luckymuniza/spinkovacka/hw_v2.0/control_board/control_board_schematic_v2.pdf

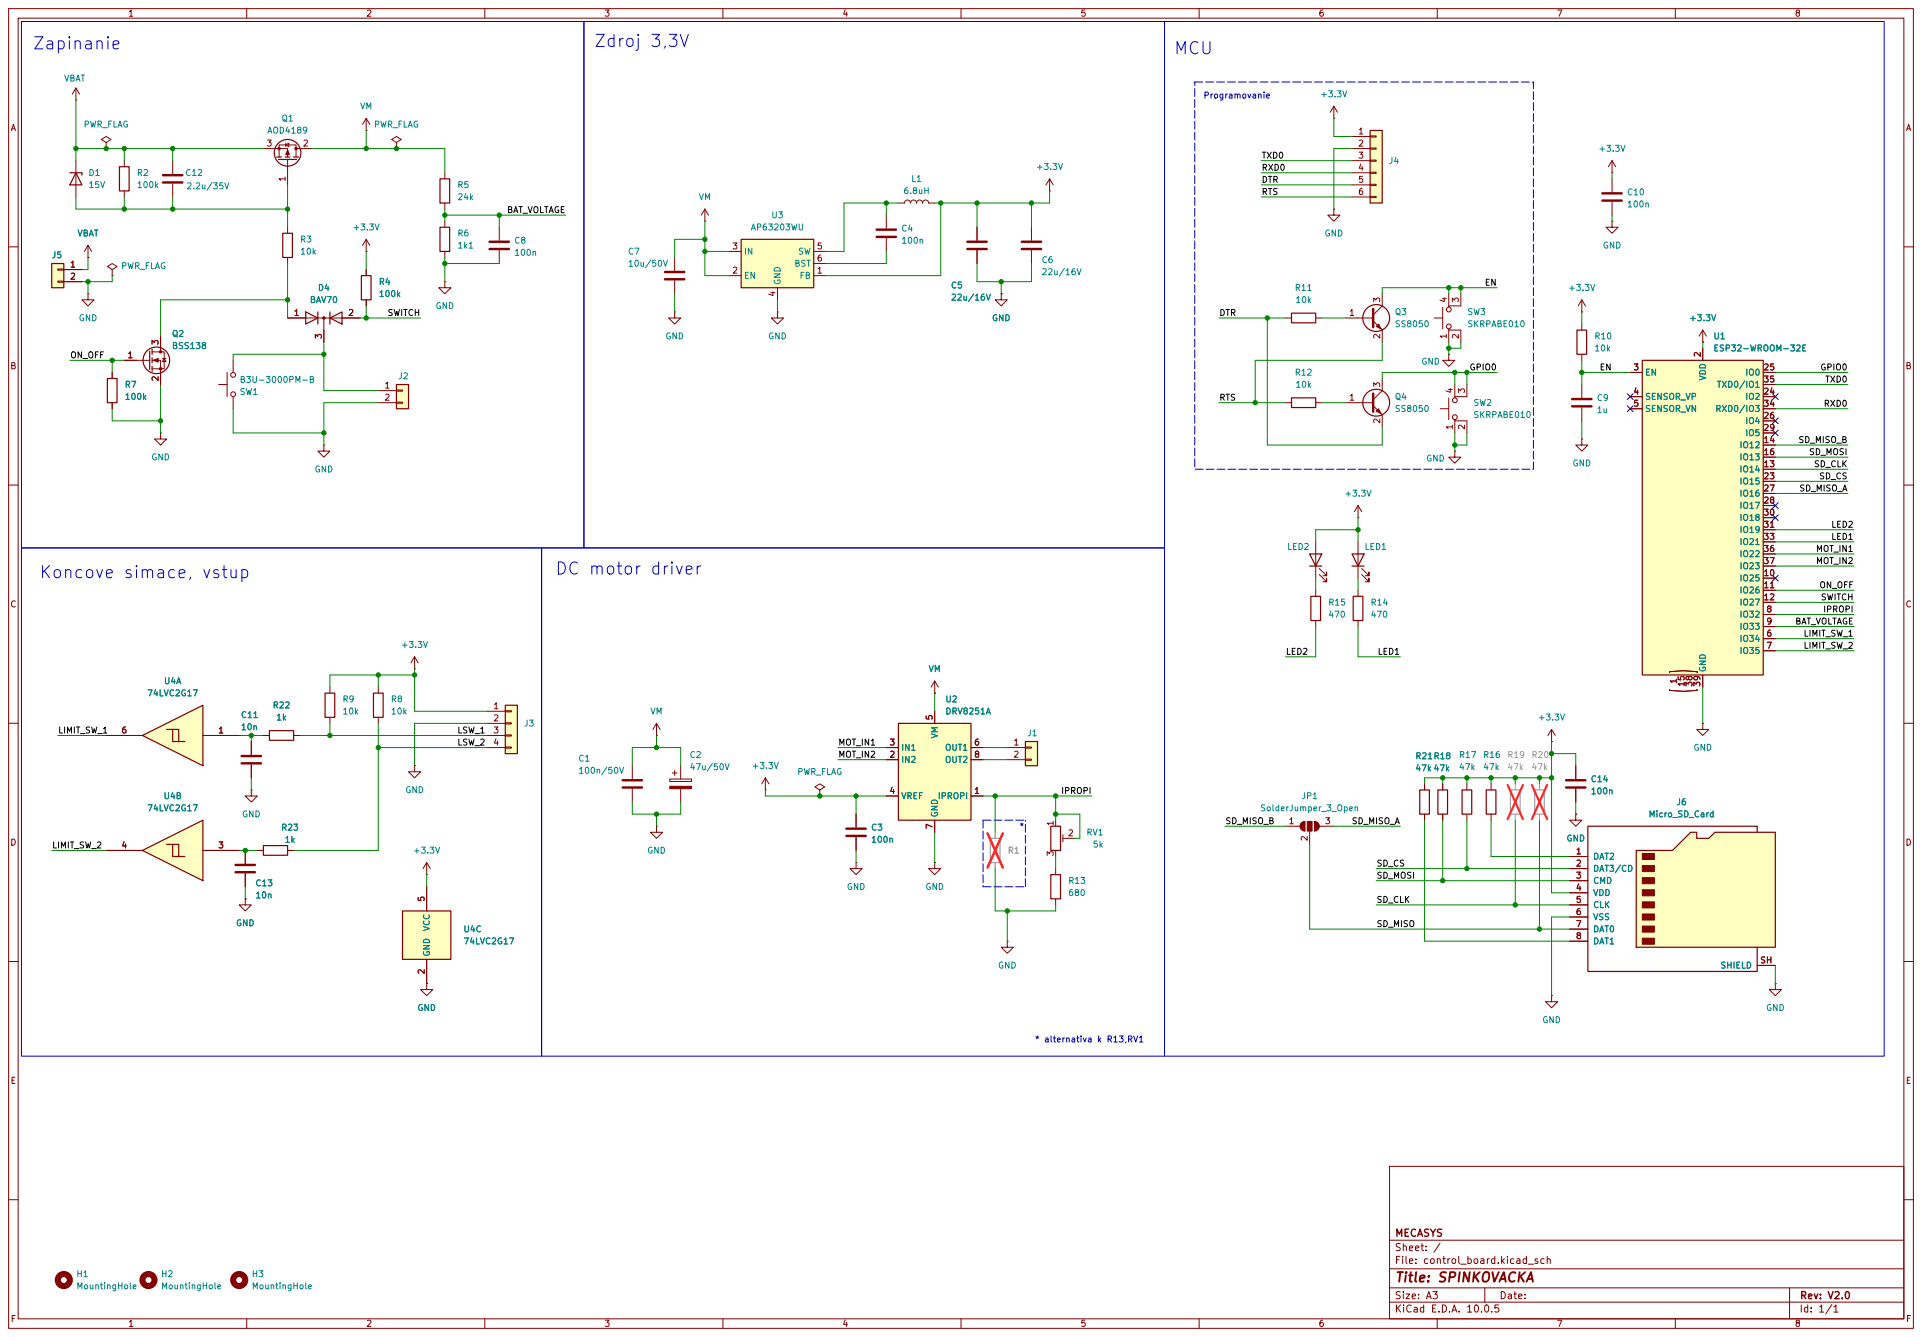
[picture p1: page 1]

Size: A3 | Rev: V2.0 | F Date:
KiCad E.D.A. 10.0.5 | Id: 1/1
