luckymuniza/spinkovacka/hw/snimac/snimac_schematic.pdf

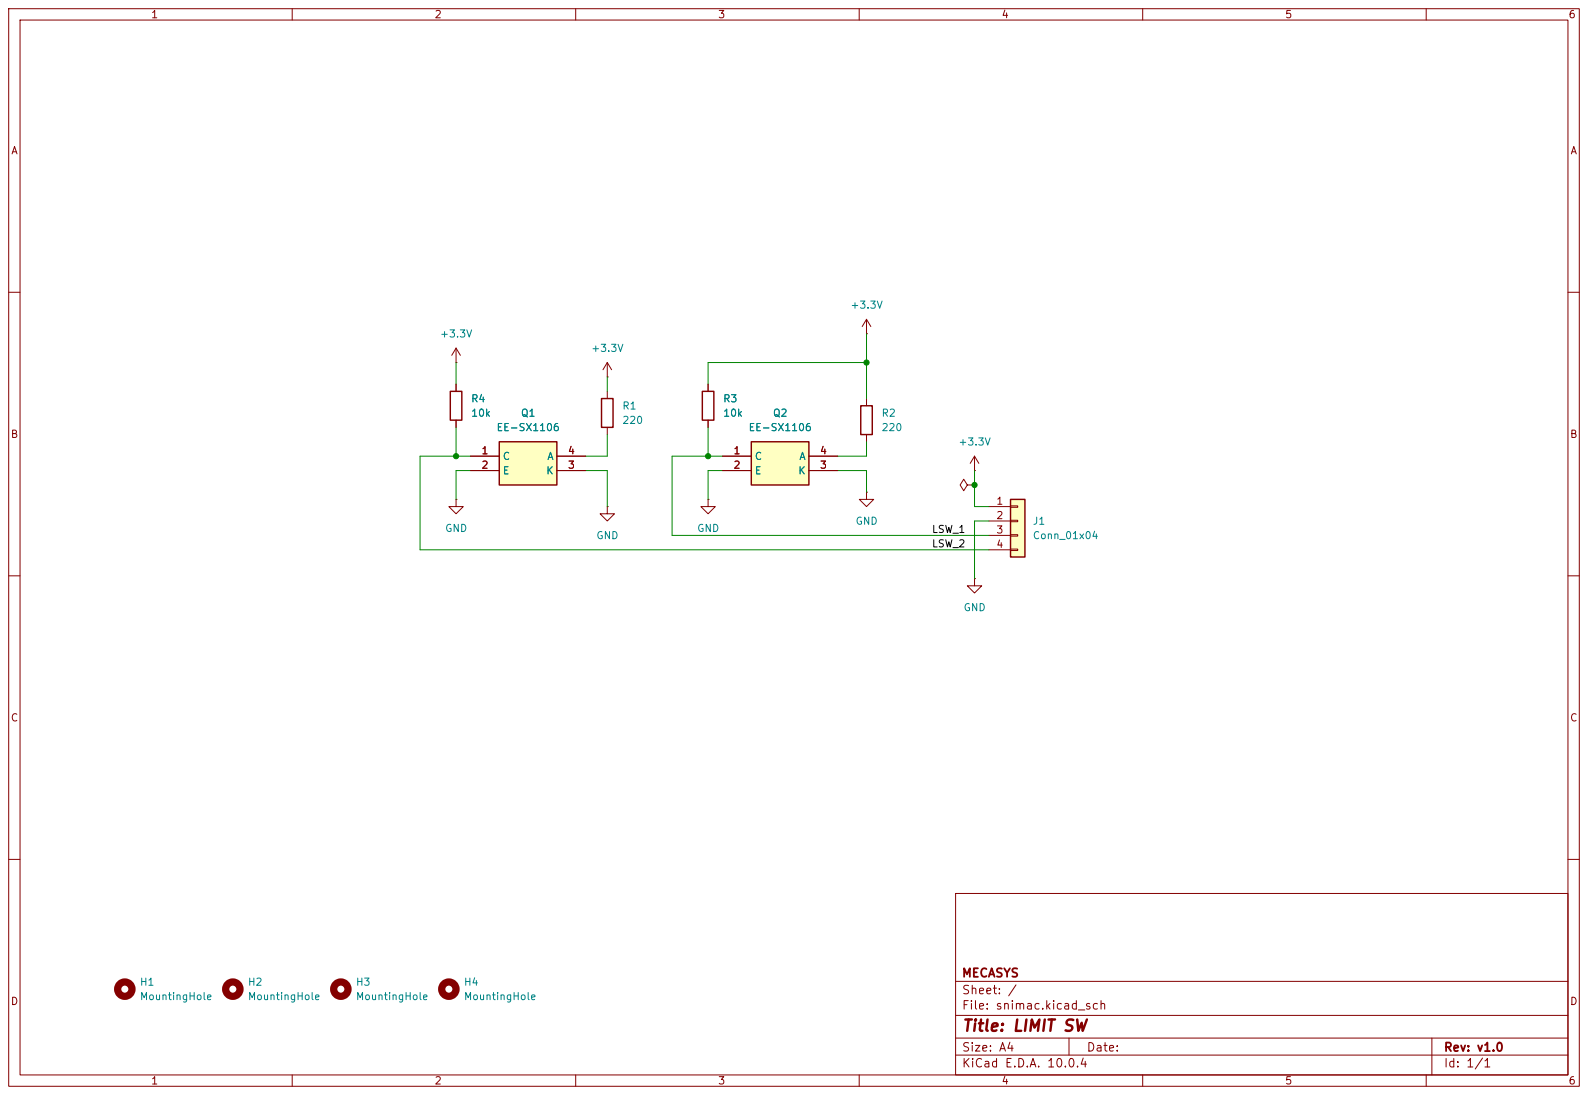
[picture p2: page 1]

Size: A4 | Rev: v1.0
KiCad E.D.A. 10.0.4 | Id: 1/1
