luckymuniza/spinkovacka/hw/control_board/control_board_schematic.pdf

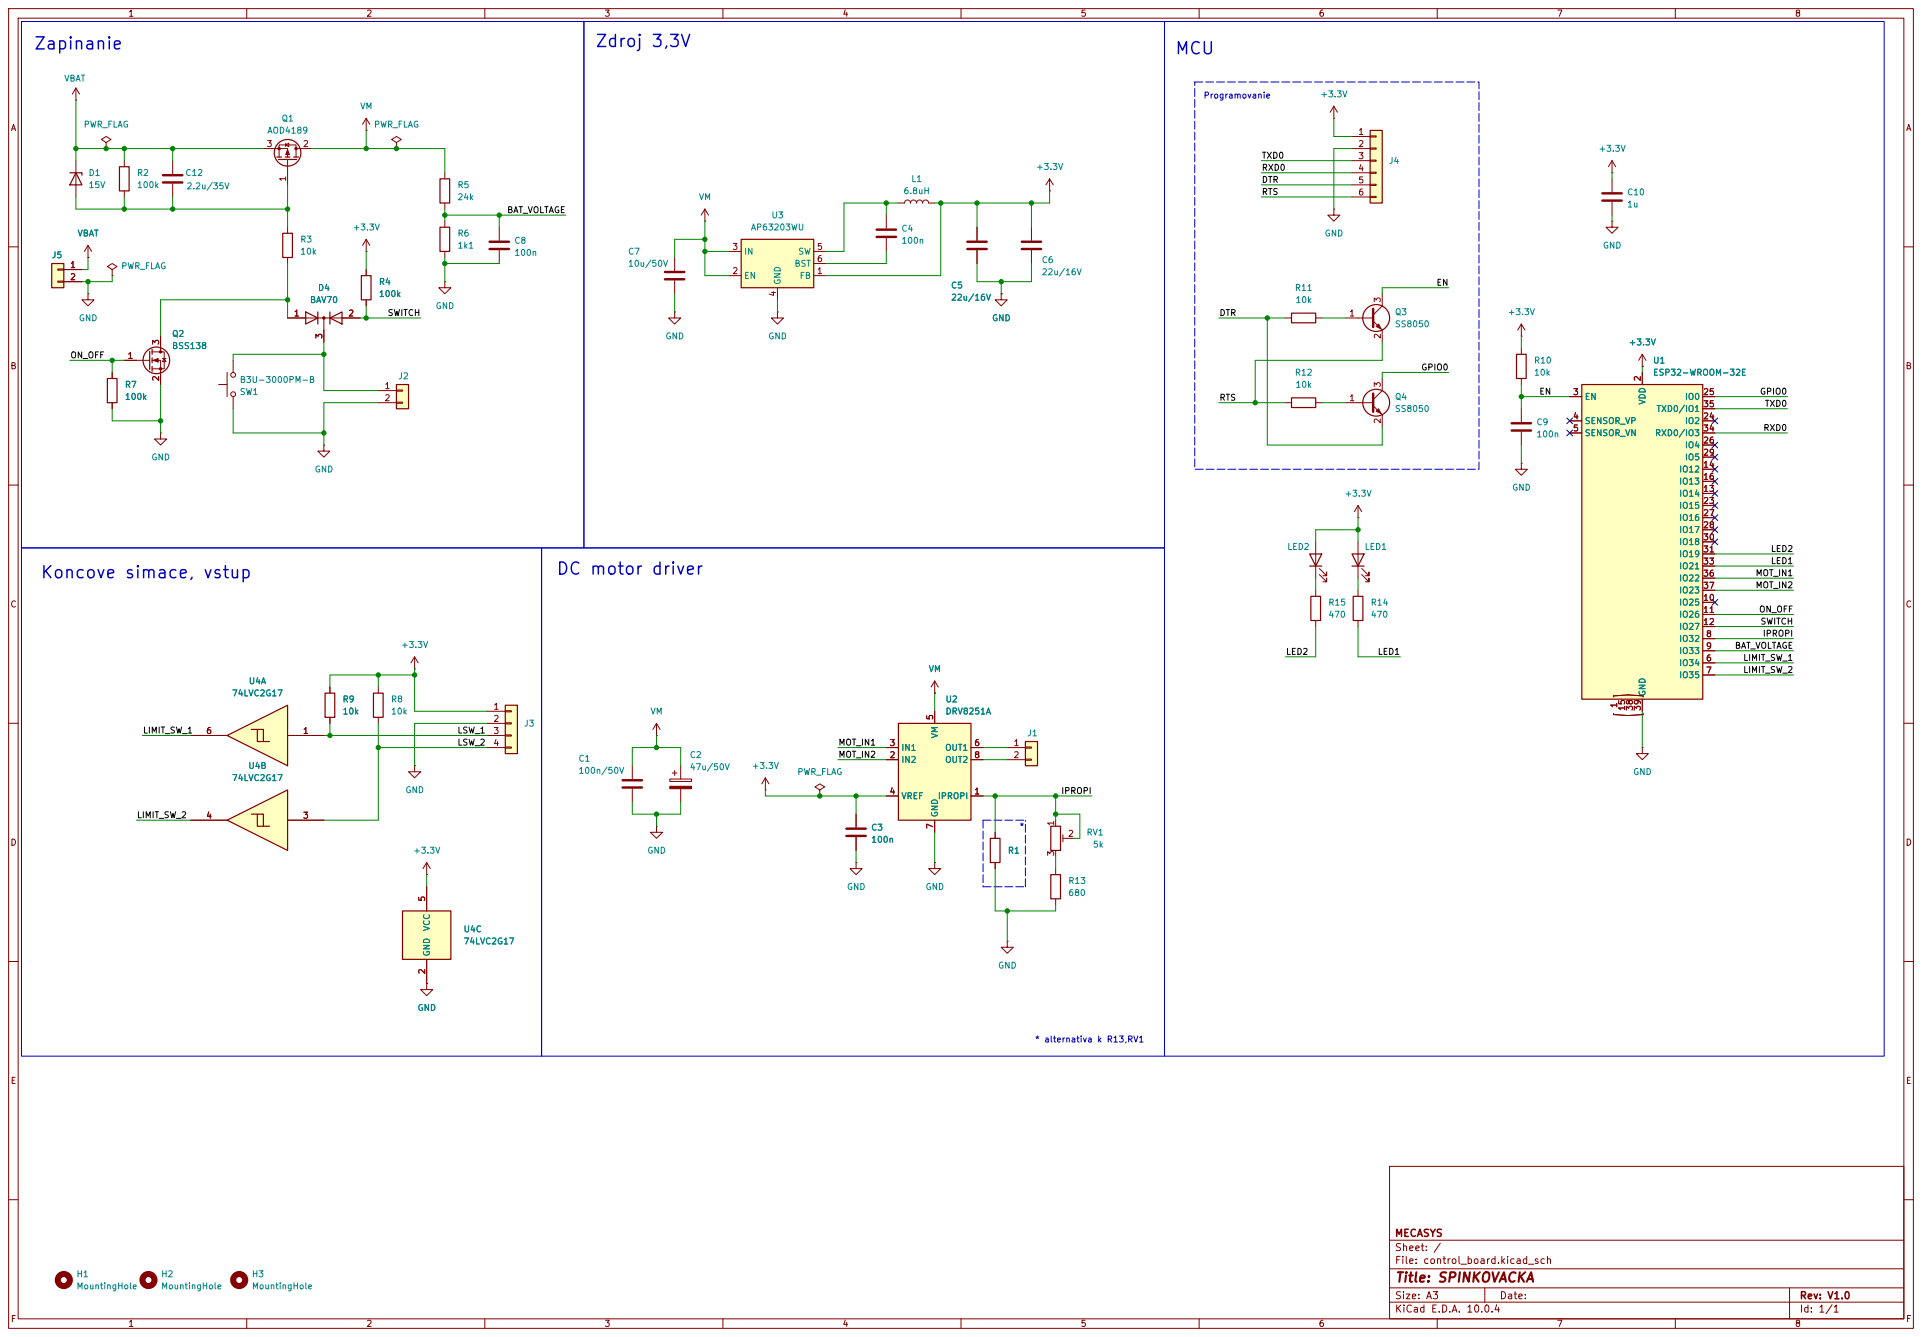
[picture p3: page 1]

RTS Koncove simace, vstup

Size: A3 | Rev: V1.0 | F Date:
KiCad E.D.A. 10.0.4 | Id: 1/1
