luckymuniza/spinkovacka/hw_v2.0/control_board/control_board.kicad_pcb

## KiCad design hw_v2.0/control_board/control_board.kicad_pcb (2026-10-12)

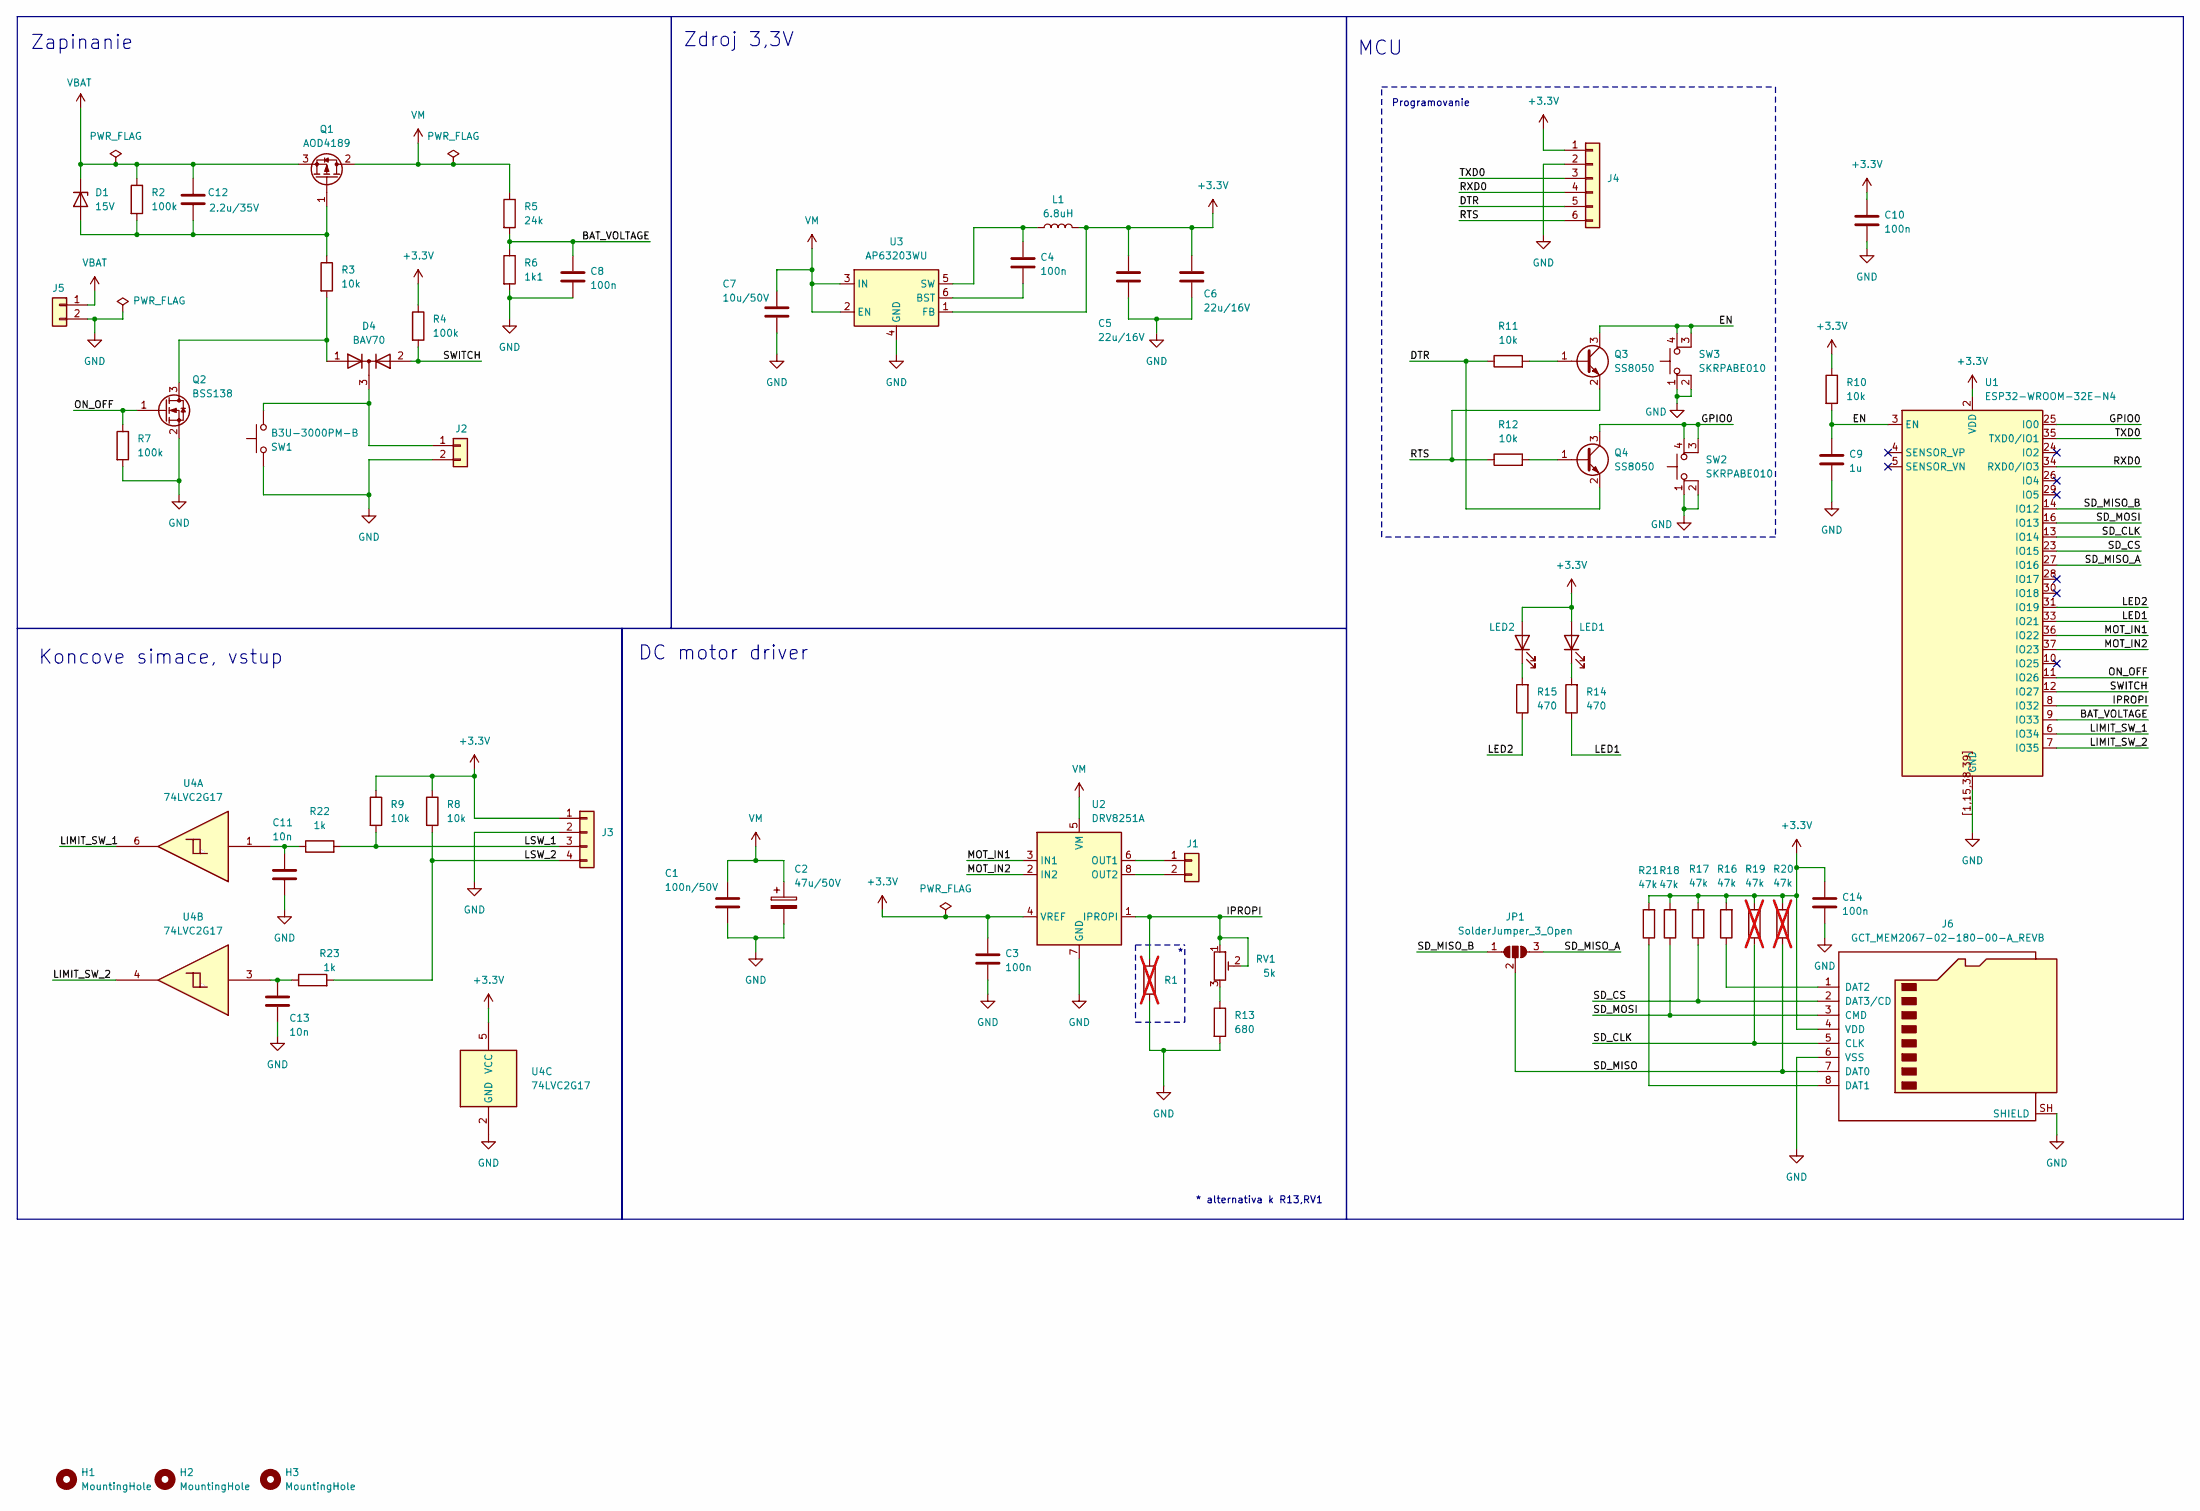
[picture p4: schematic control_board.kicad_sch, SPINKOVACKA]

Parts:
C1: 100n/50V; C_1206_3216Metric
C2: 47u/50V; CP_Elec_6.3x5.8
C3, C4, C8, C10: 100n; C_1206_3216Metric
C5, C6: 22u/16V; C_1206_3216Metric
C7: 10u/50V; C_1210_3225Metric
C9: 1u; C_1206_3216Metric
C11, C13: 10n; C_0805_2012Metric
C12: 2.2u/35V; C_1206_3216Metric
C14: 100n; C_0805_2012Metric_Pad1.18x1.45mm_HandSolder
D1: 15V; Nexperia_CFP3_SOD-123W
D4: BAV70; SOT-23
H1, H2, H3: MountingHole; MountingHole_3.2mm_M3
J1: JST_XH_B2B-XH-A_1x02_P2.50mm_Vertical
J2: JST_PH_B2B-PH-K_1x02_P2.00mm_Vertical
J3: JST_PH_B4B-PH-K_1x04_P2.00mm_Vertical
J4: JST_PH_B6B-PH-K_1x06_P2.00mm_Vertical
J5: JST_VH_B2PS-VH_1x02_P3.96mm_Horizontal
J6: GCT_MEM2067-02-180-00-A_REVB
JP1: SolderJumper_3_Open; SolderJumper-3_P1.3mm_Open_RoundedPad1.0x1.5mm_NumberLabels
L1: 6.8uH; L_Panasonic_PCC-M0530M
LED1, LED2: LED_1206_3216Metric
Q1: AOD4189; TO-252-2
Q2: BSS138; SOT-23
Q3, Q4: SS8050; SOT-23
R1: 1k5; R_0805_2012Metric; not fitted
R2, R4, R7: 100k; R_0805_2012Metric
R3, R8, R9, R10, R11, R12: 10k; R_0805_2012Metric
R5: 24k; R_0805_2012Metric
R6: 1k1; R_0805_2012Metric
R13: 680; R_0805_2012Metric
R14, R15: 470; R_0805_2012Metric
R16, R17, R18, R21: 47k; R_0805_2012Metric
R19, R20: 47k; R_0805_2012Metric; not fitted
R22, R23: 1k; R_0805_2012Metric
RV1: 5k; Potentiometer_Bourns_3314J_Vertical
SW1: B3U-3000PM-B; SW_SPST_B3U-3000P-B
SW2, SW3: SKRPABE010; SW_TACT_ALPS_SKRPABE010
U1: ESP32-WROOM-32E-N4; ESP32-WROOM-32E
U2: DRV8251A; SOIC-8-1EP_3.9x4.9mm_P1.27mm_EP2.95x4.9mm_Mask2.71x3.4mm_Th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
U3: AP63203WU; TSOT-23-6
U4: 74LVC2G17; SOT-23-6

Connections:
+3.3V: C3.1, C5.1, C6.1, C10.1, C14.1, J3.1, J4.1, J6.4 (VDD), L1.2, LED1.2 (A), LED2.2 (A), R4.1, R8.1, R9.1, R10.1, R16.2, R17.2, R18.2, R19.2, R20.2, R21.2, U1.2 (VDD), U2.4 (VREF), U3.1 (FB), U4.5 (VCC)
/BAT_VOLTAGE: C8.1, R5.2, R6.1, U1.9 (IO33)
/DTR: J4.5, Q4.2 (E), R11.1
/EN: C9.1, Q3.3 (C), R10.2, SW3.3 (K), SW3.4 (A), U1.3 (EN)
/GPIO0: Q4.3 (C), SW2.3 (K), SW2.4 (A), U1.25 (IO0)
/IPROPI: R1.1, RV1.1, RV1.2, U1.8 (IO32), U2.1 (IPROPI)
/LED1: R14.1, U1.33 (IO21)
/LED2: R15.1, U1.31 (IO19)
/LIMIT_SW_1: U1.6 (IO34), U4.6
/LIMIT_SW_2: U1.7 (IO35), U4.4
/LSW_1: J3.3, R9.2, R22.2
/LSW_2: J3.4, R8.2, R23.2
/MOT_IN1: U1.36 (IO22), U2.3 (IN1)
/MOT_IN2: U1.37 (IO23), U2.2 (IN2)
/ON_OFF: Q2.1 (G), R7.1, U1.11 (IO26)
/RTS: J4.6, Q3.2 (E), R12.1
/RXD0: J4.4, U1.34 (RXD0/IO3)
/SD_CLK: J6.5 (CLK), R19.1, U1.13 (IO14)
/SD_CS: J6.2 (DAT3/CD), R17.1, U1.23 (IO15)
/SD_MISO: J6.7 (DAT0), JP1.2 (C), R20.1
/SD_MISO_A: JP1.3 (B), U1.27 (IO16)
/SD_MISO_B: JP1.1 (A), U1.14 (IO12)
/SD_MOSI: J6.3 (CMD), R18.1, U1.16 (IO13)
/SWITCH: D4.2 (A), R4.2, U1.12 (IO27)
/TXD0: J4.3, U1.35 (TXD0/IO1)
GND: C1.2, C2.2, C3.2, C5.2, C6.2, C7.2, C8.2, C9.2, C10.2, C11.2, C13.2, C14.2, J2.2, J3.2, J4.2, J5.2, J6.6 (VSS), J6.SH (SHIELD), Q2.2 (S), R1.2, R6.2, R7.2, R13.2, SW1.2, SW2.1, SW2.2, SW3.1, SW3.2, U1.1 (GND), U1.15 (GND), U1.38 (GND), U1.39 (GND), U1.[1,15,38,39] (GND), U2.7 (GND), U2.9 (GND), U3.4 (GND), U4.2 (GND)
unnamed: C11.1, R22.1, U4.1
unnamed: C13.1, R23.1, U4.3
unnamed: C12.2, D1.2 (A), Q1.1 (G), R2.2, R3.1
unnamed: D4.3 (K), J2.1, SW1.1
unnamed: J1.1, U2.6 (OUT1)
unnamed: J1.2, U2.8 (OUT2)
unnamed: J6.8 (DAT1), R21.1
unnamed: J6.1 (DAT2), R16.1
unnamed: LED1.1 (K), R14.2
unnamed: LED2.1 (K), R15.2
unnamed: D4.1 (A), Q2.3 (D), R3.2
unnamed: Q3.1 (B), R11.2
unnamed: Q4.1 (B), R12.2
unnamed: R13.1, RV1.3
unnamed: C4.2, U3.6 (BST)
unnamed: C4.1, L1.1, U3.5 (SW)
VBAT: C12.1, D1.1 (K), J5.1, Q1.3 (S), R2.1
VM: C1.1, C2.1, C7.1, Q1.2 (D), R5.1, U2.5 (VM), U3.2 (EN), U3.3 (IN)

Notes on the sheet:
MCU
Zapinanie
Zdroj 3,3V
Koncove simace, vstup
Programovanie
DC motor driver
* alternativa k R13,RV1

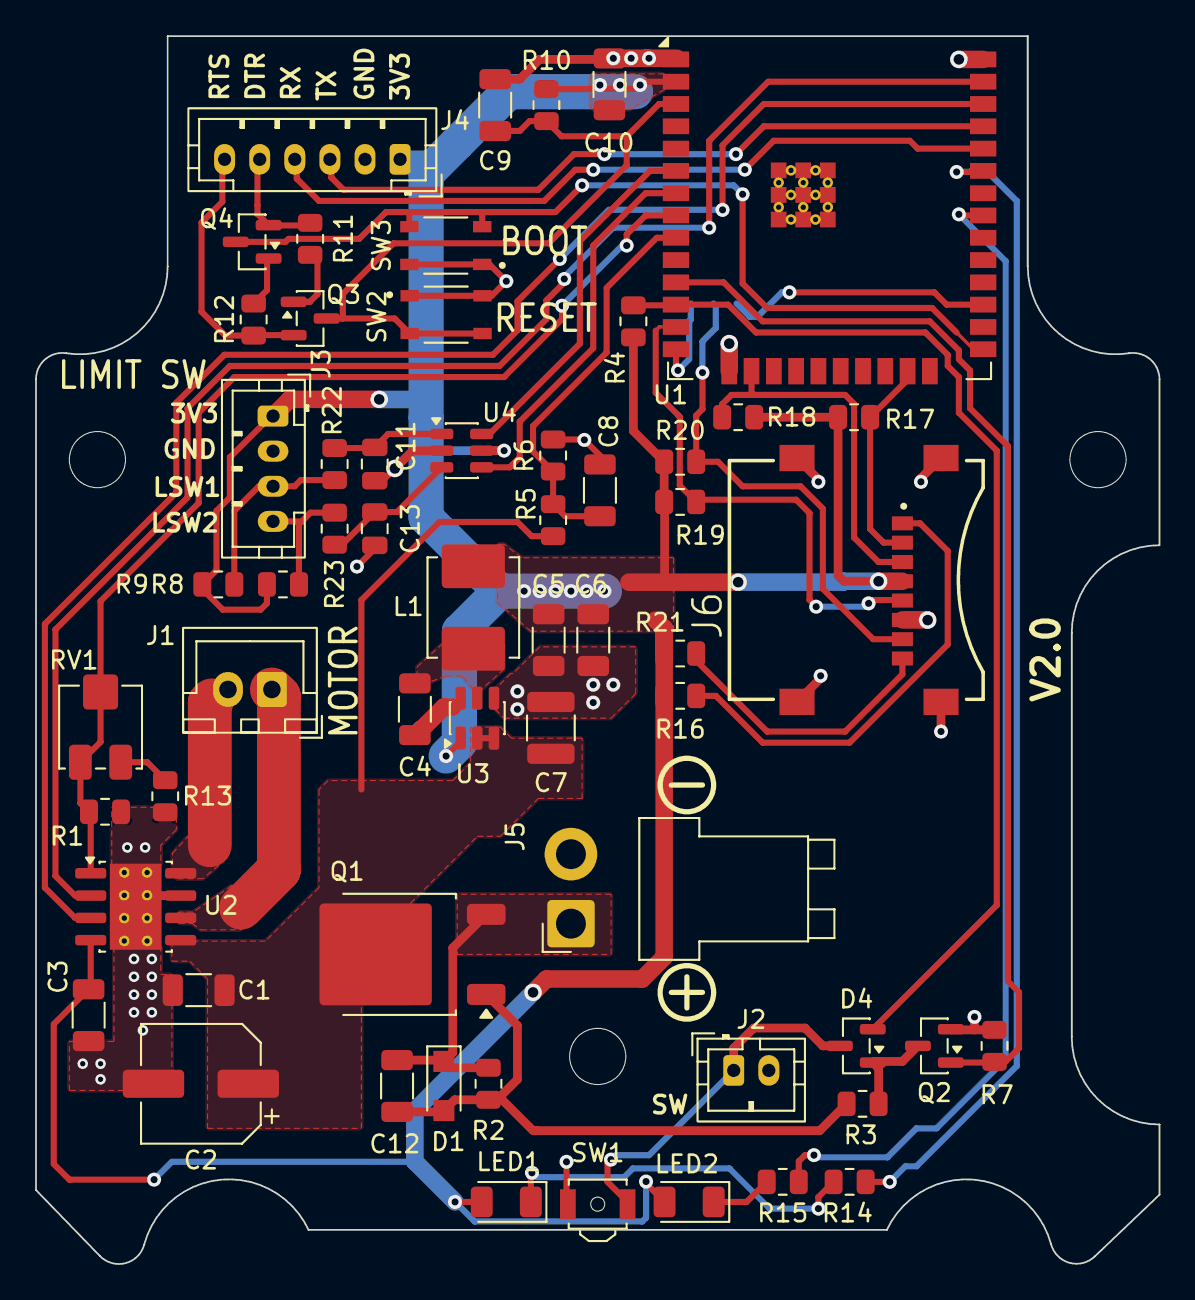
[picture p5: board control_board.kicad_pcb from above]

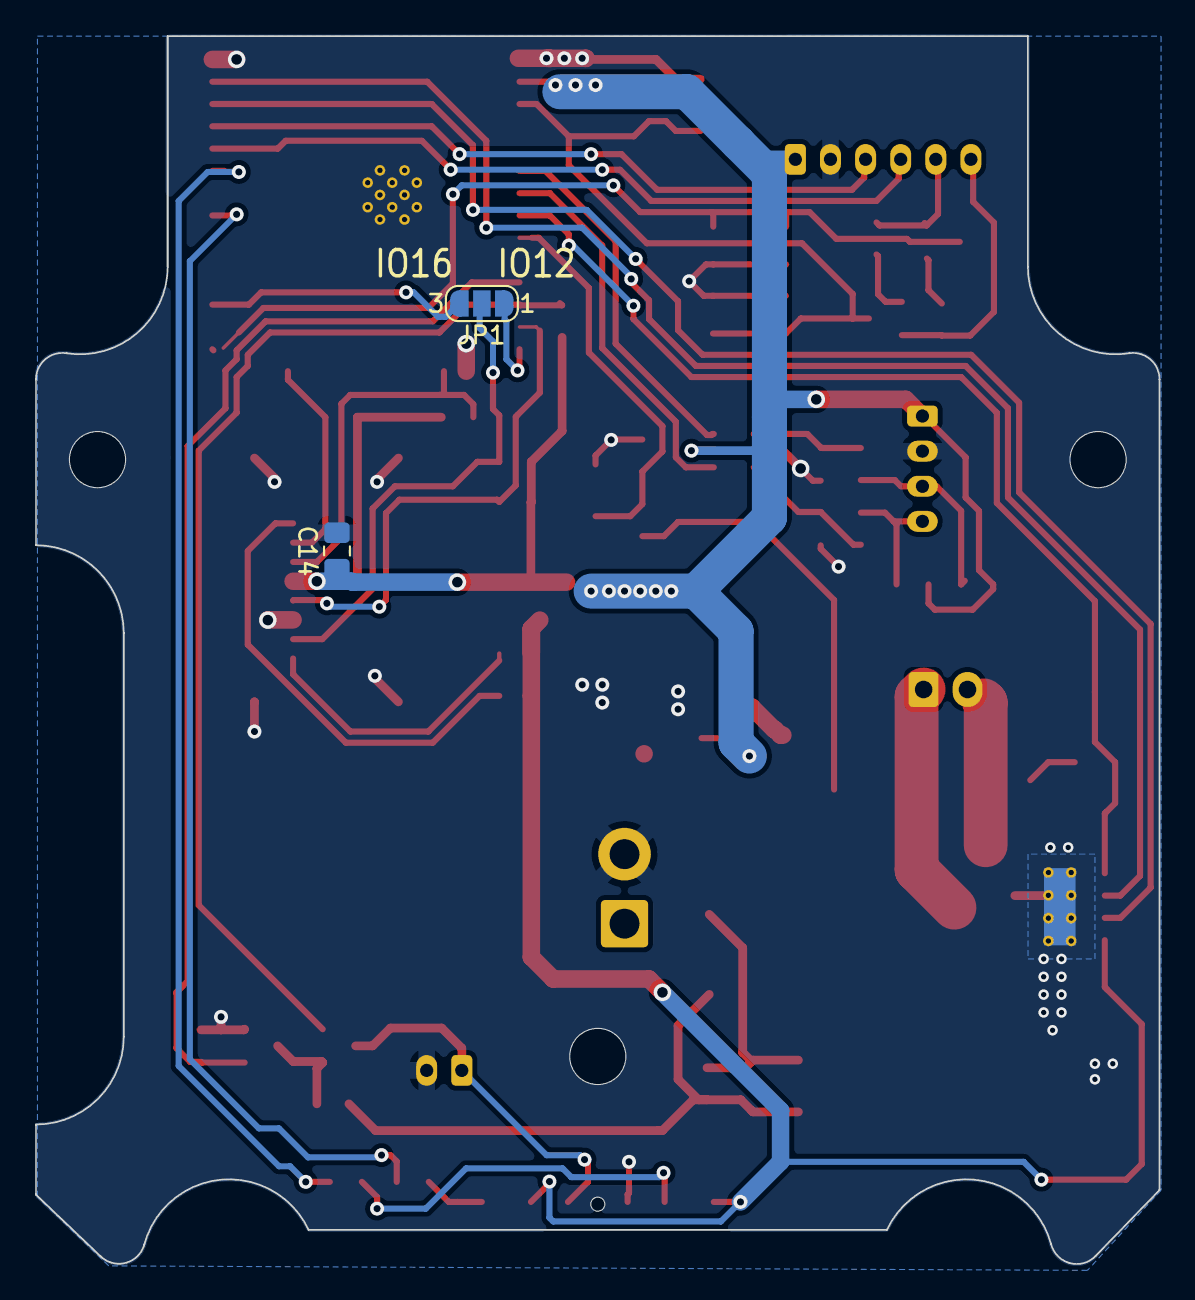
[picture p6: board control_board.kicad_pcb from below]

Board: 2 copper layers, 64.0 x 69.9 mm, 64 parts (2 on the bottom side), 44 nets.
