luckymuniza/spinkovacka/hw_v1.0/snimac/snimac.kicad_pcb

## KiCad design hw_v1.0/snimac/snimac.kicad_pcb (2026-10-11, an earlier design)

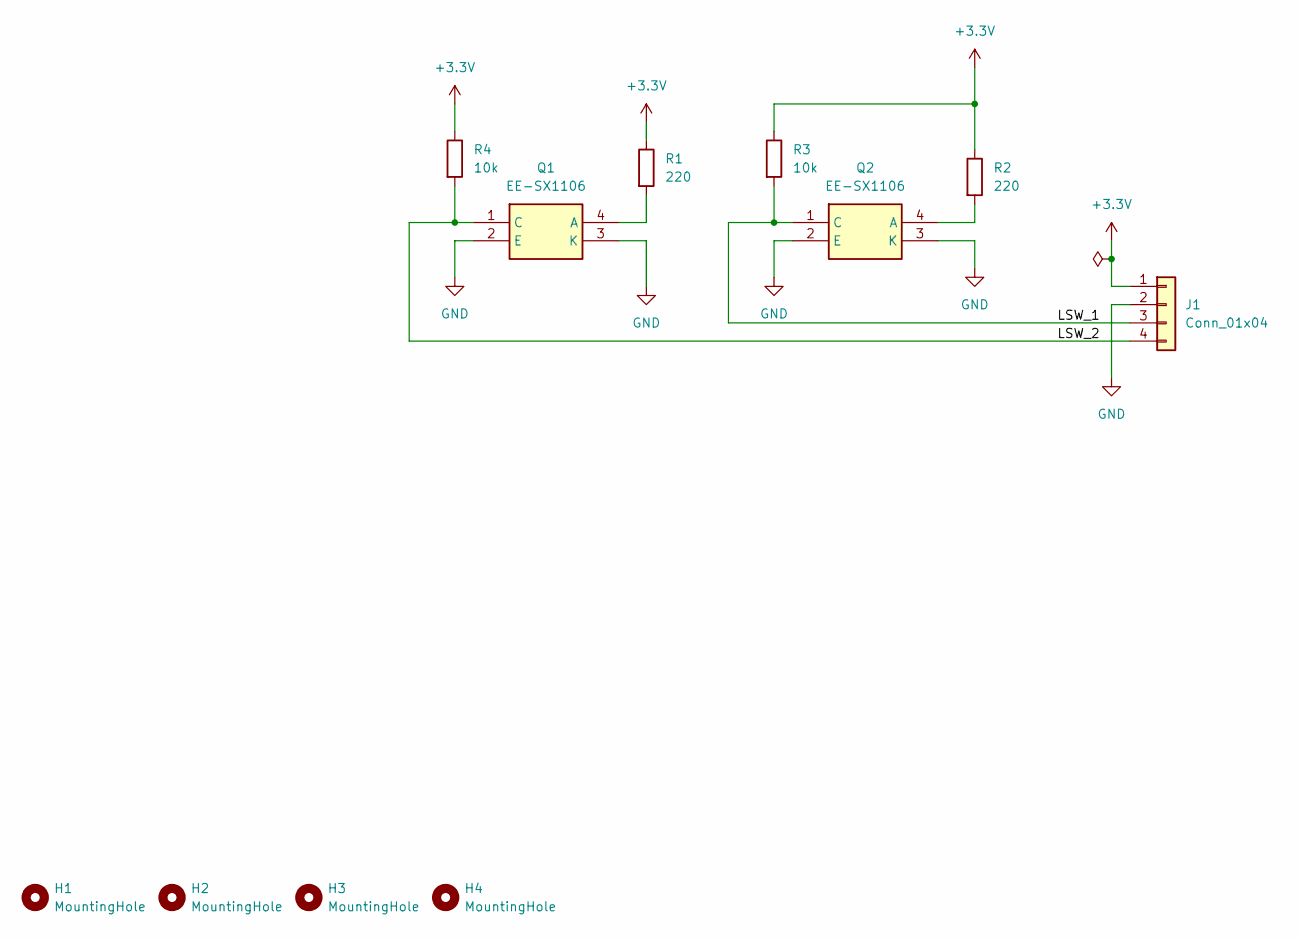
[picture p7: schematic snimac.kicad_sch, LIMIT SW]

Parts:
H1, H2, H3, H4: MountingHole; MountingHole_2.5mm
J1: Conn_01x04; JST_PH_B4B-PH-K_1x04_P2.00mm_Vertical
Q1, Q2: EE-SX1106; EESX1106; Manufacturer_Part_Number EE-SX1106; Mouser Part Number 653-EE-SX1106
R1, R2: 220; R_0805_2012Metric_Pad1.20x1.40mm_HandSolder
R3, R4: 10k; R_0805_2012Metric_Pad1.20x1.40mm_HandSolder

Connections:
+3.3V: J1.1, R1.1, R2.1, R3.1, R4.1
/LSW_1: J1.3, Q2.1 (C), R3.2
/LSW_2: J1.4, Q1.1 (C), R4.2
GND: J1.2, Q1.2 (E), Q1.3 (K), Q2.2 (E), Q2.3 (K)
unnamed: Q1.4 (A), R1.2
unnamed: Q2.4 (A), R2.2

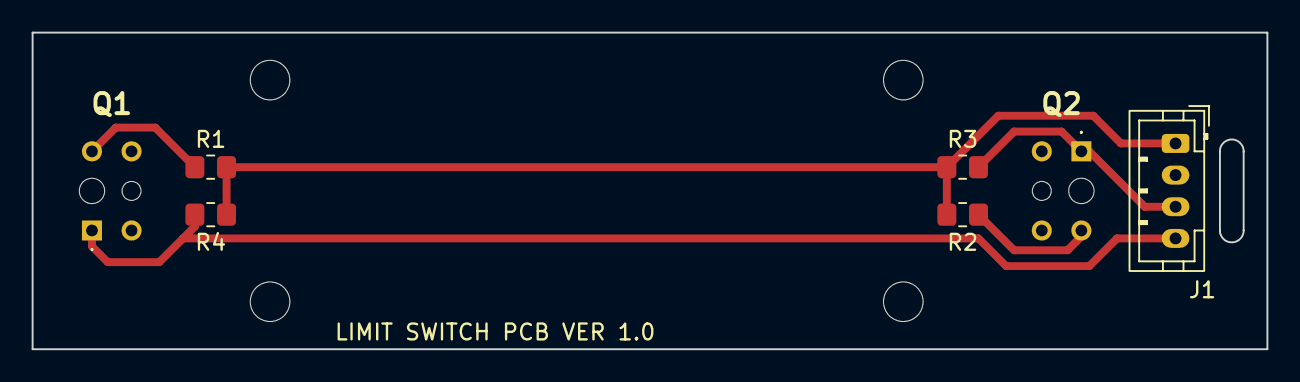
[picture p8: board snimac.kicad_pcb from above]

Board: 2 copper layers, 78.0 x 20.0 mm, 11 parts (0 on the bottom side), 6 nets.
