luckymuniza/spinkovacka/(commit log)

2026-07-19 gitignore added cad
2026-07-20 control_board schema update
    [control_board.kicad_sch]
2026-09-04 hw: split into hw_v1.0 and add hw_v2.0
    Rename hw/ to hw_v1.0/ (archived first revision) and add the reworked
    hw_v2.0/ boards. Ignore KiCad lock files and .history/.
    Claude-Session: https://claude.ai/code/session_015DnfXsA2vzfPVyPUwRhHDM
    [control_board-B_Cu.gbl, control_board-B_Mask.gbs, control_board-B_Paste.gbp, control_board-B_Silkscreen.gbo, control_board-Edge_Cuts.gm1, control_board-F_Cu.gtl, control_board-F_Mask.gts, control_board-F_Paste.gtp]
2026-09-07 limit sw filter added
    [control_board.kicad_pcb, control_board.kicad_sch, snimac.kicad_pcb]
2026-09-07 revision num corrected
    [control_board.kicad_pcb, control_board.kicad_sch]
2026-10-12 added sensor connector labels
